JKI757/Robot_Jetson/pics/IMG_3620.jpeg

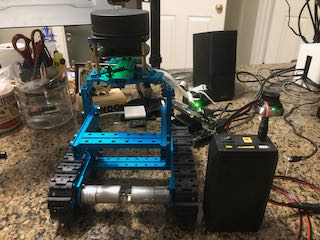
pics/IMG_3620.jpeg
