JKI757/Robot_Jetson/pics/IMG_4070.jpeg

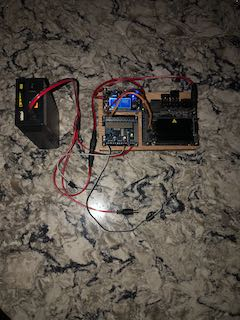
pics/IMG_4070.jpeg
