JKI757/Robot_Jetson/pics/IMG_4074.jpeg

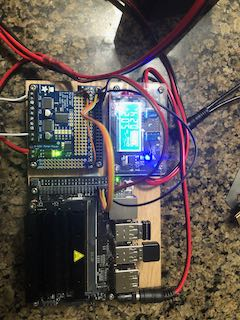
pics/IMG_4074.jpeg
