JKI757/Robot_Jetson/pics/IMG_5163.jpeg

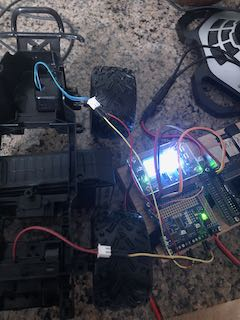
pics/IMG_5163.jpeg
