JKI757/Robot_Jetson/pics/IMG_5699.jpeg

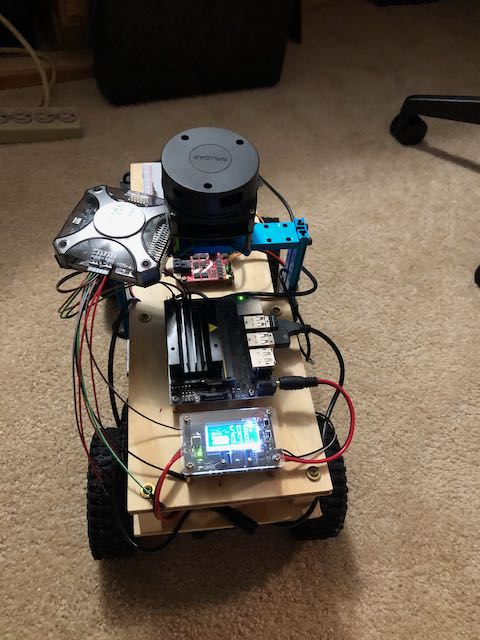
pics/IMG_5699.jpeg
