JKI757/Robot_Jetson/pics/IMG_5700.jpeg

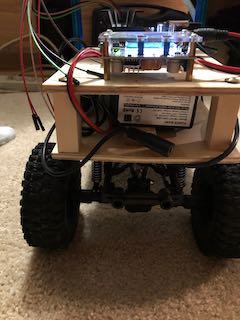
pics/IMG_5700.jpeg
