JKI757/Robot_Jetson/pics/IMG_5701.jpeg

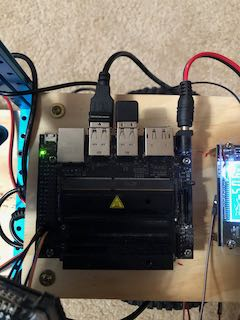
pics/IMG_5701.jpeg
