JKI757/Robot_Jetson/lidar_driver.cpp

/*
 * To change this license header, choose License Headers in Project Properties.
 * To change this template file, choose Tools | Templates
 * and open the template in the editor.
 */

/* 
 * File:   lidar_driver.cpp
 * Author: josh
 * 
 * Created on March 19, 2020, 11:26 PM
 */

#include "lidar_driver.h"

lidar_driver::lidar_driver(const lidar_driver& orig) {
}

lidar_driver::~lidar_driver() {

    driver->stop();
    driver->stopMotor();

    rp::standalone::rplidar::RPlidarDriver::DisposeDriver(driver);

    //delete(driver);//Don't know if this is required
}
