JKI757/Robot_Jetson/(commit log)

2019-08-18 add gpio and i2c
2019-10-23 wiring pi included
2019-10-24 manual mode works, tank mode broken
    [EventHandler.cpp, Robot.cpp, Robot.h]
2019-10-24 tank mode fixes, auto mode fixes
    [EventHandler.cpp]
2020-01-22 modify to accommodate real front end steering and rear single motor differential drive
2020-01-24 add disconnect button command -- BTN-X
2020-03-20 add LIDAR support, add definitions, fix up motor control, add arduino motor & steering control
    [EventHandler.cpp, EventHandler.h, Motor.cpp, Motor.h, Robot.cpp, Robot.h, definitions.h, lidar_driver.cpp]
2020-03-22 fixing up gamepad issues
    [EventHandler.cpp, Robot.cpp, Robot.h, definitions.h, lidar_driver.cpp, main.cpp]
2020-03-22 add mapping logic & fixup errors
    [EventHandler.cpp, Motor.cpp, Motor.h, Robot.cpp, Robot.h, main.cpp]
2020-03-26 adding back i2c
2020-04-27 working steering w/ nodemcu drive and steering controller
2020-05-01 final push before moving over to jetson only
2020-05-29 first build after jetson pwm refactor - untested
2020-06-05 semi-working draft jetson /no pwm controller -- pwm signals exist, but probably need pullups to get them to work.
2020-06-05 fix readme for jetson-pwm branch
